dk5ee/LiRX/extra/Versandkosten.png

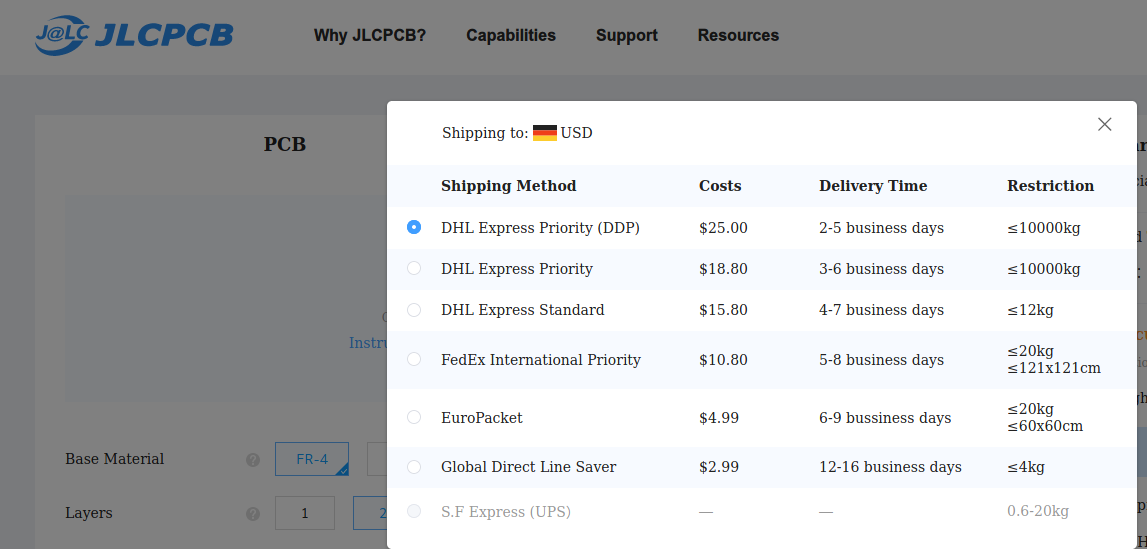
extra/Versandkosten.png
