dk5ee/LiRX/LiRX_3d.png

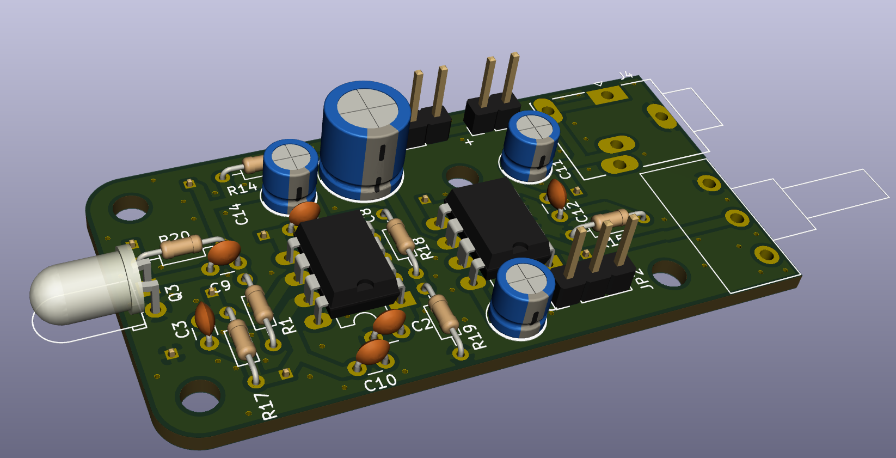
LiRX_3d.png
