dk5ee/LiRX/LiRX_pcb.png

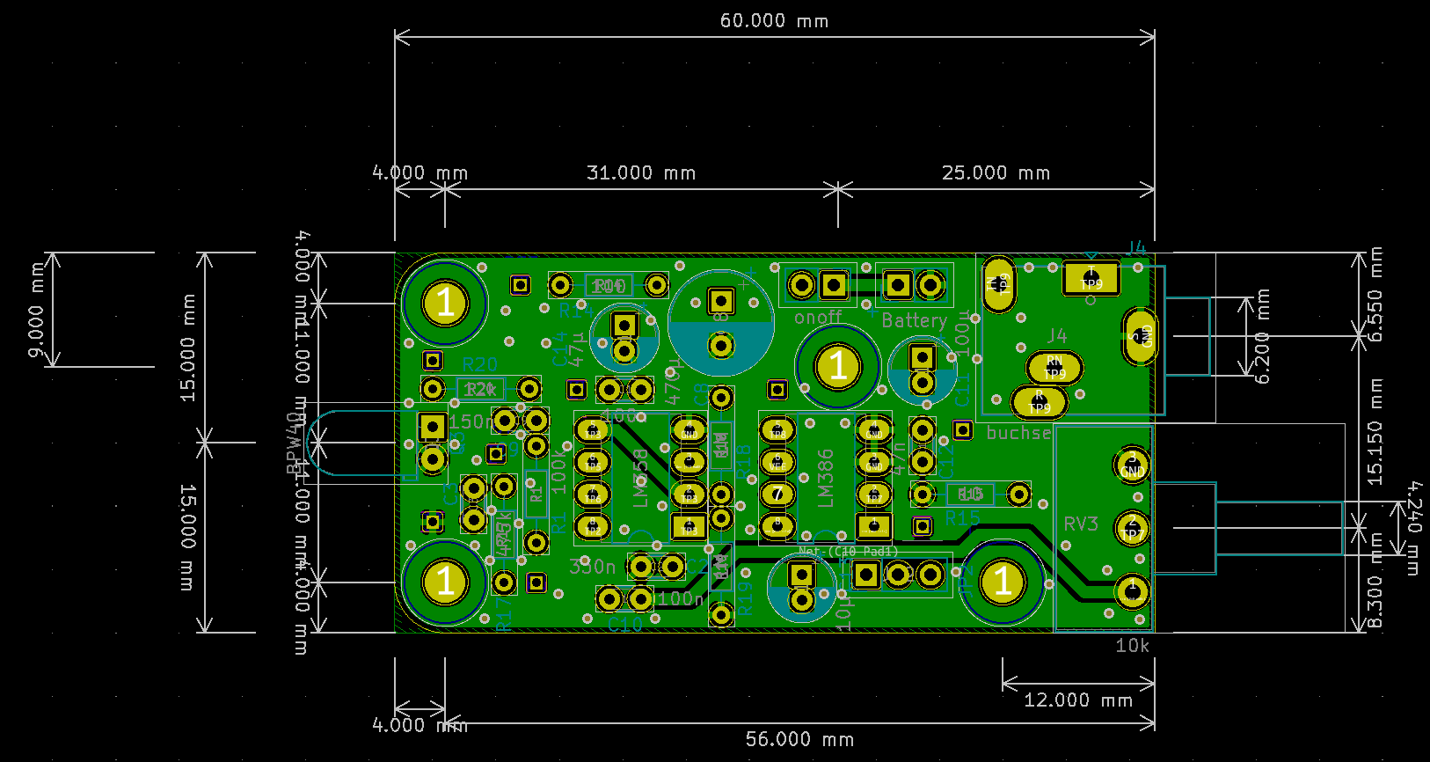
LiRX_pcb.png
