dk5ee/LiRX/LiRX_schematic.png

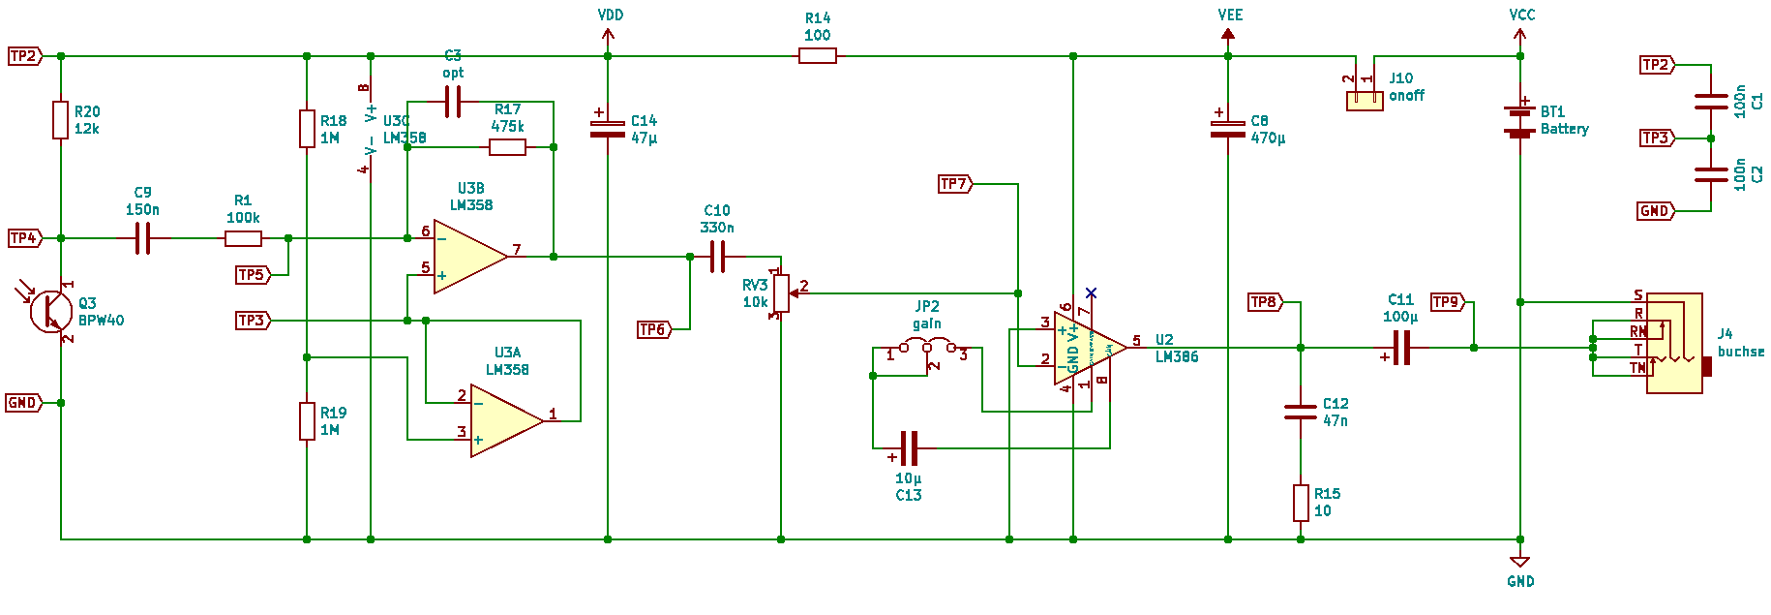
LiRX_schematic.png
