dk5ee/LiRX/LiRXprototype.jpg

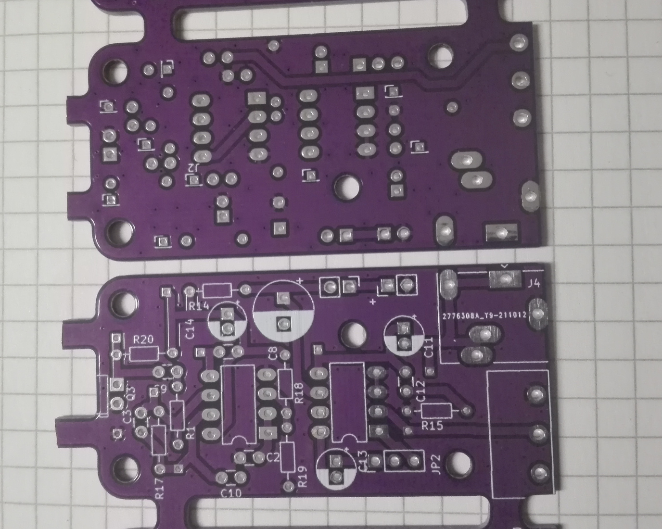
LiRXprototype.jpg
