dk5ee/LiRX/lirx_gehaeuse.stl

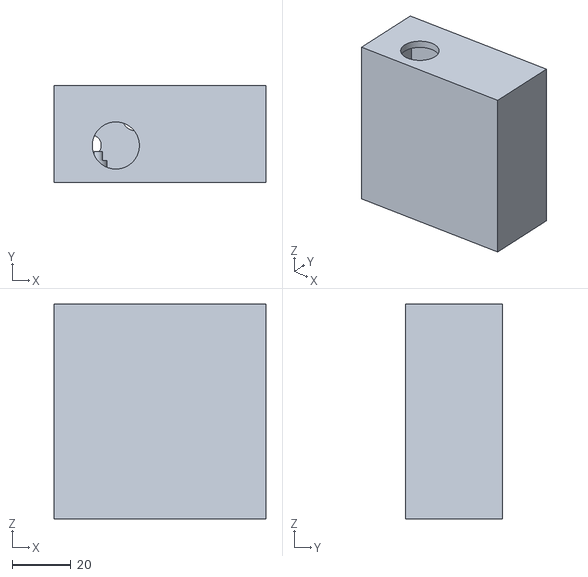
[picture p6: CAD file, 2021-10-19]
lirx_gehaeuse.stl
72.0 x 33.0 x 73.0
