dk5ee/LiRX/LiRX_tht/LiRX_tht.pdf

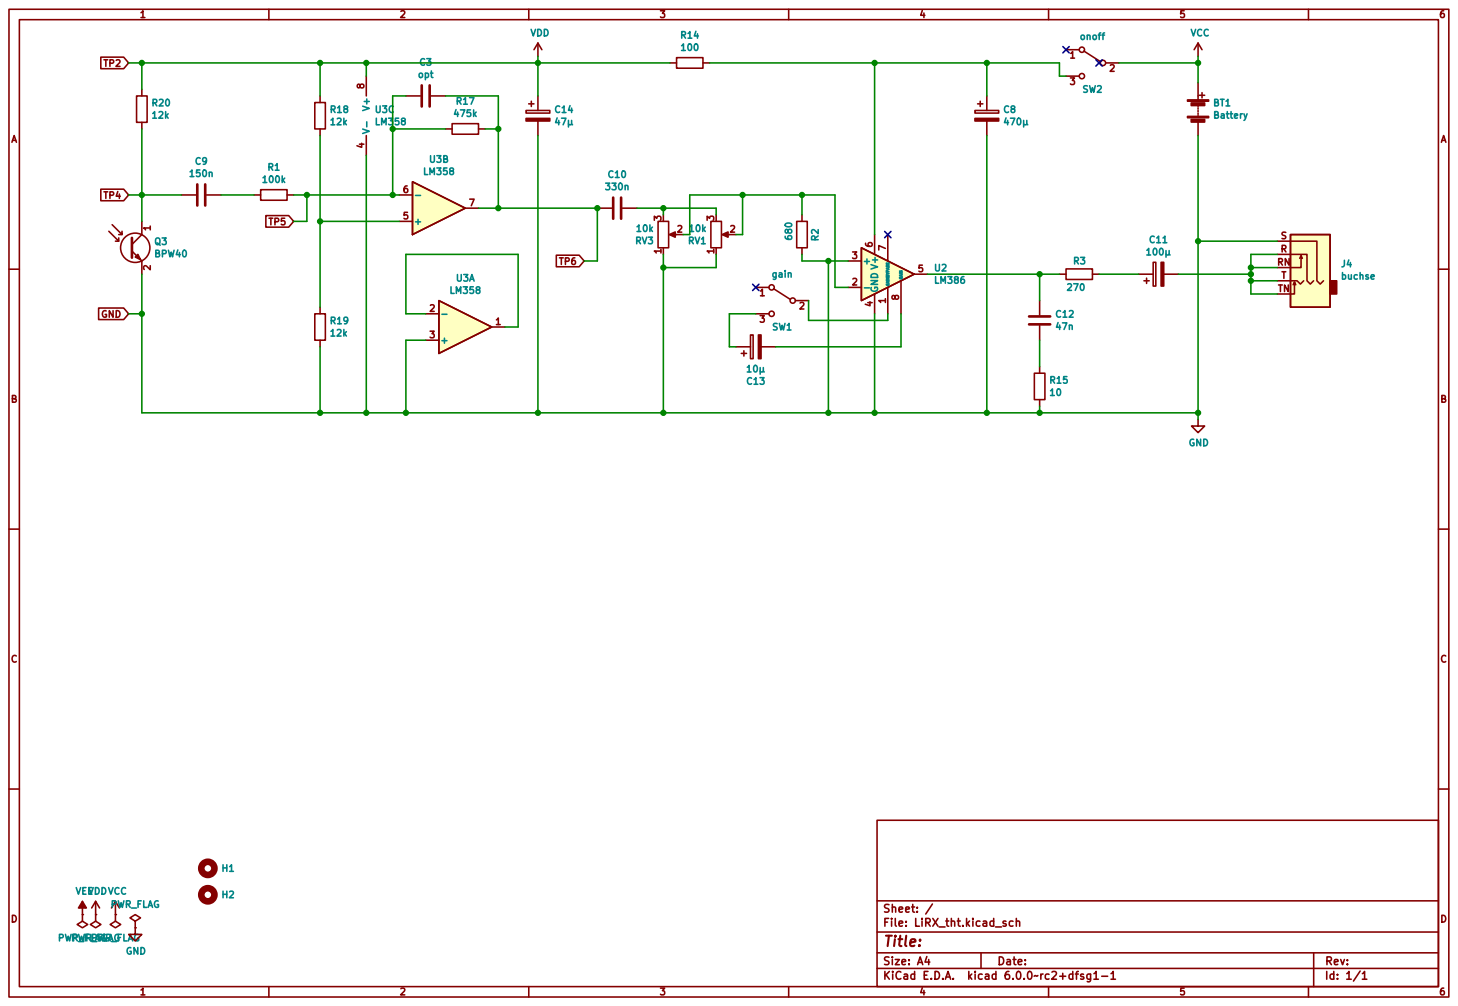
[picture p7: page 1]
