dk5ee/LiRX/LiRX_tht/LiRXgerber/LiRX_tht-B_Cu.pdf

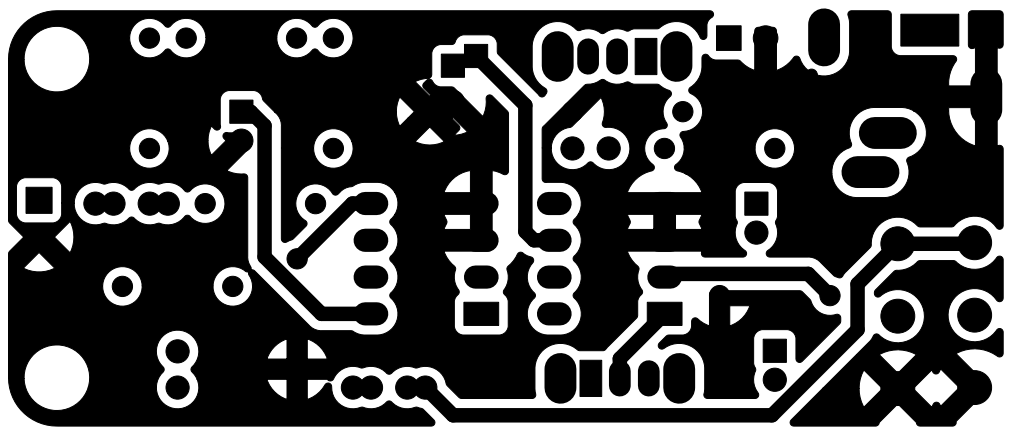
[picture p8: page 1]
