dk5ee/LiRX/LiRX_tht/LiRXgerber/LiRX_tht-B_Mask.pdf

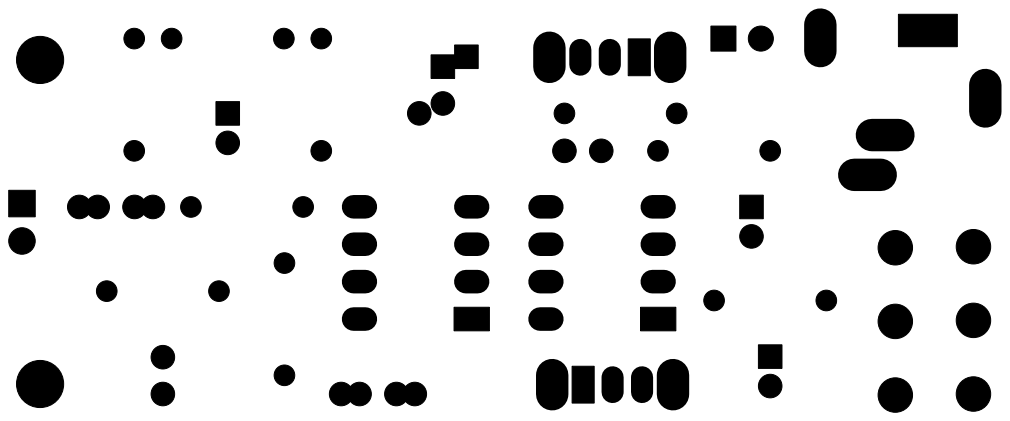
[picture p9: page 1]
