dk5ee/LiRX/LiRX_tht/LiRXgerber/LiRX_tht-Edge_Cuts.pdf

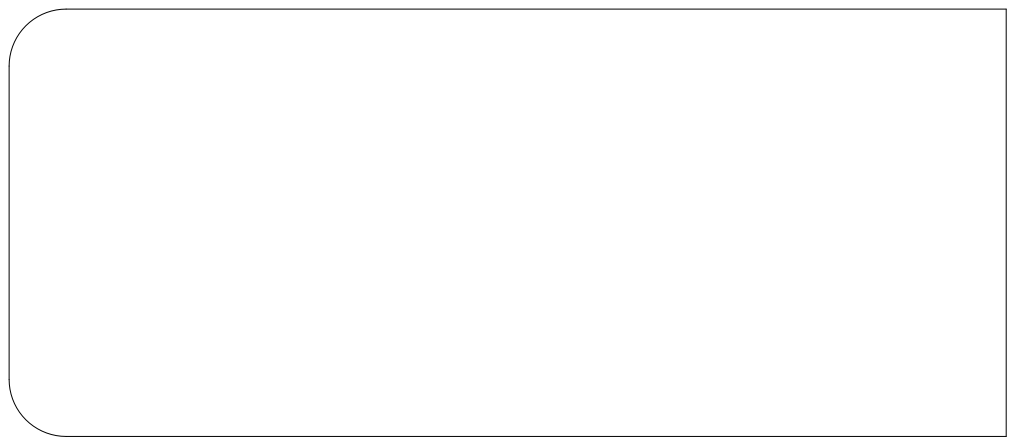
[picture p10: page 1]
