dk5ee/LiRX/LiRX_tht/LiRXgerber/LiRX_tht-F_Cu.pdf

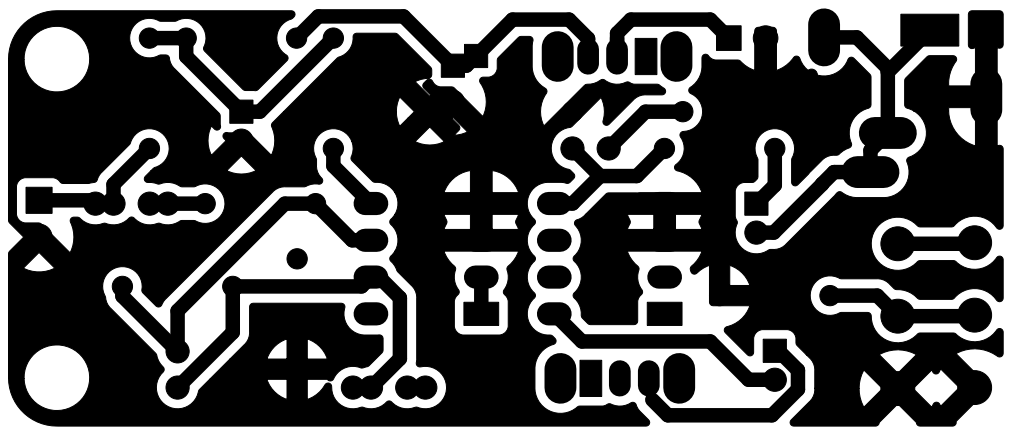
[picture p11: page 1]
