dk5ee/LiRX/LiRX_tht/LiRXgerber/LiRX_tht-F_Silkscreen.pdf

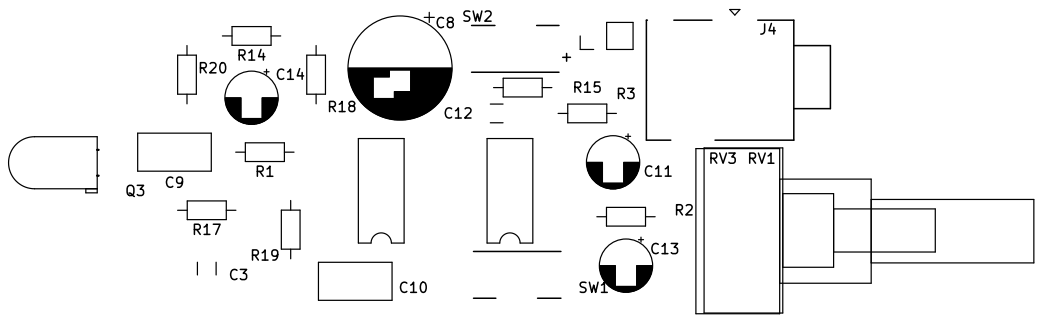
[picture p12: page 1]
