dk5ee/LiRX/LiRX_tht/LiRX_tht.kicad_pcb

## KiCad design LiRX_tht/LiRX_tht.kicad_pcb (2022-01-14)

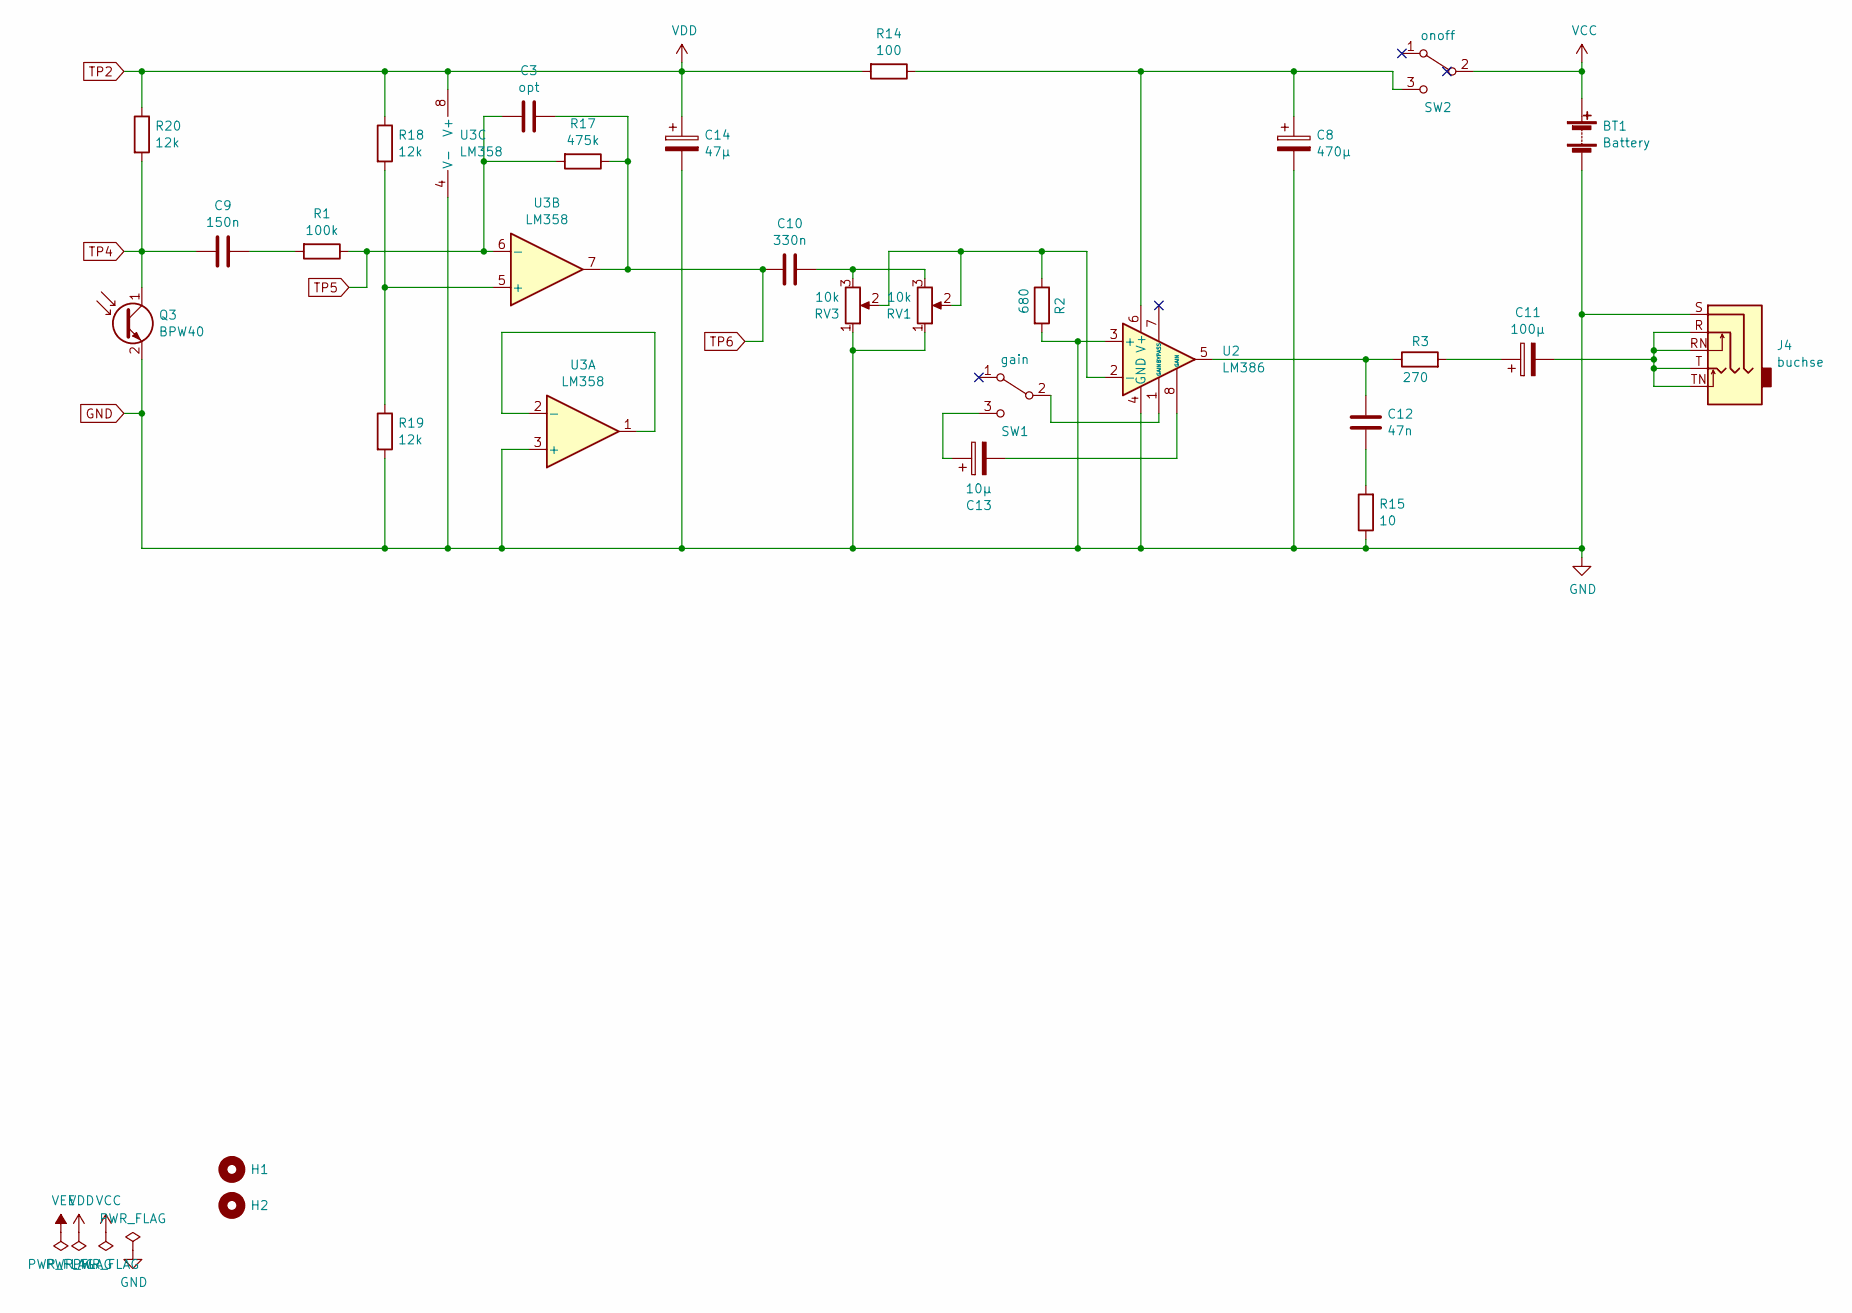
[picture p13: schematic LiRX_tht.kicad_sch]

Parts:
BT1: Battery; PinHeader_1x02_P2.54mm_Vertical
C3: opt; C_Disc_D3.0mm_W1.6mm_P2.50mm
C8: 470µ; CP_Radial_D10.0mm_P2.50mm_P5.00mm
C9: 150n; C_Rect_L7.0mm_W3.5mm_P2.50mm_P5.00mm
C10: 330n; C_Rect_L7.0mm_W3.5mm_P2.50mm_P5.00mm
C11: 100µ; CP_Radial_D5.0mm_P2.00mm
C12: 47n; C_Disc_D3.0mm_W1.6mm_P2.50mm
C13: 10µ; CP_Radial_D5.0mm_P2.00mm
C14: 47µ; CP_Radial_D5.0mm_P2.00mm
H1, H2: MountingHole; MountingHole_3.2mm_M3
J4: buchse; Jack_3.5mm_Ledino_KB3SPRS_Horizontal
Q3: BPW40; LED_D5.0mm_Horizontal_O1.27mm_Z3.0mm_Clear
R1: 100k; R_Axial_DIN0204_L3.6mm_D1.6mm_P7.62mm_Horizontal
R2: 680; R_Axial_DIN0204_L3.6mm_D1.6mm_P7.62mm_Horizontal
R3: 270; R_Axial_DIN0204_L3.6mm_D1.6mm_P7.62mm_Horizontal
R14: 100; R_Axial_DIN0204_L3.6mm_D1.6mm_P7.62mm_Horizontal
R15: 10; R_Axial_DIN0204_L3.6mm_D1.6mm_P7.62mm_Horizontal
R17: 475k; R_Axial_DIN0204_L3.6mm_D1.6mm_P7.62mm_Horizontal
R18, R19, R20: 12k; R_Axial_DIN0204_L3.6mm_D1.6mm_P7.62mm_Horizontal
RV1: 10k; Potentiometer_Piher_T-16H_Single_Horizontal
RV3: 10k; Potentiometer_Piher_PC-16_Single_Horizontal
SW1: gain; SW_CuK_OS102011MA1QN1_SPDT_Angled
SW2: onoff; SW_CuK_OS102011MA1QN1_SPDT_Angled
U2: LM386; DIP-8_W7.62mm_LongPads
U3: LM358; DIP-8_W7.62mm_LongPads

Connections:
GND: BT1.2 (-), C8.2, C14.2, J4.S, Q3.2 (E), R2.2, R15.1, R19.2, RV1.1, RV3.1, U2.3 (+), U2.4 (GND), U3.3 (+), U3.4 (V-)
unnamed: C8.1, R14.1, SW2.3 (C), U2.6 (V+)
unnamed: C9.1, R1.2
unnamed: C10.1, RV1.3, RV3.3
unnamed: C11.1, R3.2
unnamed: C11.2, J4.R, J4.RN, J4.T, J4.TN
unnamed: C12.1, R3.1, U2.5
unnamed: C12.2, R15.2
unnamed: C13.1, SW1.3 (C)
unnamed: C13.2, U2.8 (GAIN)
unnamed: R2.1, RV1.2, RV3.2, U2.2 (-)
unnamed: R18.2, R19.1, U3.5 (+)
unnamed: SW1.2 (B), U2.1 (GAIN)
unnamed: U3.1, U3.2 (-)
TP2: C14.1, R14.2, R18.1, R20.1, U3.8 (V+)
TP4: C9.2, Q3.1 (C), R20.2
TP5: C3.2, R1.1, R17.2, U3.6 (-)
TP6: C3.1, C10.2, R17.1, U3.7
VCC: BT1.1 (+), SW2.2 (B)

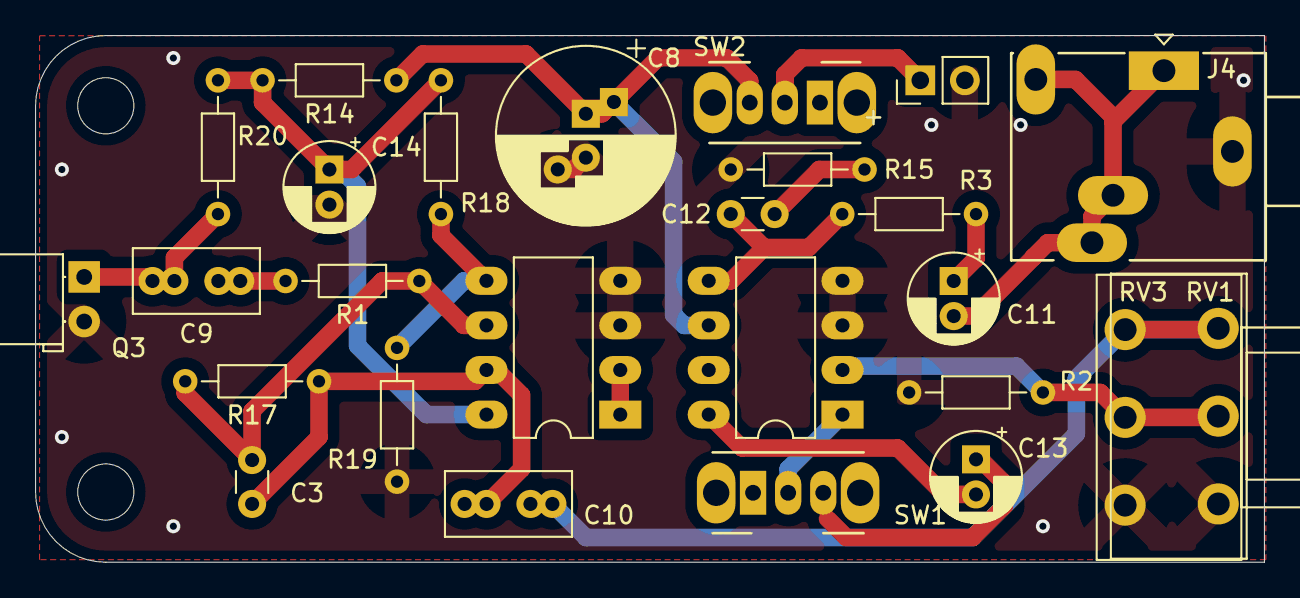
[picture p14: board LiRX_tht.kicad_pcb from above]

Board: 2 copper layers, 70.0 x 30.0 mm, 28 parts (0 on the bottom side), 19 nets.
