dk5ee/LiRX/Anleitung/testpoints.png

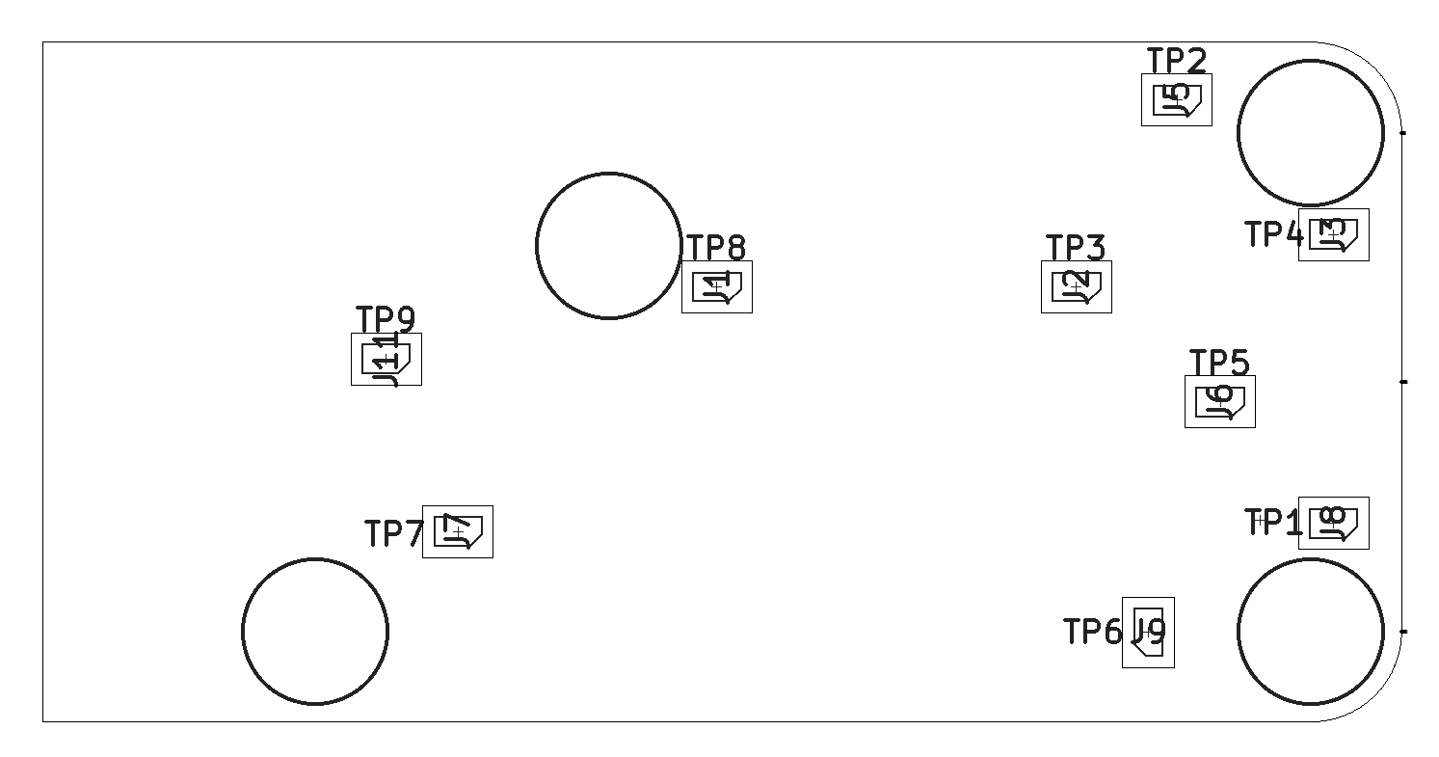
Anleitung/testpoints.png
