dk5ee/LiRX/(commit log)

2021-10-11 import Kicad schematics and PCB
    [LiRX_tht.kicad_pcb, LiRX_tht.sch]
2021-10-11 cleanup and plot
    [LiRX_tht-B_Cu.gbr, LiRX_tht-B_Mask.gbr, LiRX_tht-B_Paste.gbr, LiRX_tht-B_SilkS.gbr, LiRX_tht-Edge_Cuts.gbr, LiRX_tht-F_Cu.gbr, LiRX_tht-F_Mask.gbr, LiRX_tht-F_Paste.gbr]
2021-10-14 correct gitignore to include BOM
    [LiRX_tht.csv]
2021-10-14 Added DXF files
    [LiRX_tht-B_Cu.dxf, LiRX_tht-B_Mask.dxf, LiRX_tht-B_Paste.dxf, LiRX_tht-B_SilkS.dxf, LiRX_tht-Edge_Cuts.dxf, LiRX_tht-F_Cu.dxf, LiRX_tht-F_Mask.dxf, LiRX_tht-F_Paste.dxf]
2021-10-23 picture of prototype
2021-10-26 Schematic PDF
2022-01-05 Added Suggestions; 1cm longer; kicad 6.0
    [LiRX_tht-B_Cu.dxf, LiRX_tht-B_Mask.dxf, LiRX_tht-B_Paste.dxf, LiRX_tht-B_SilkS.dxf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]
2022-01-14 Anleitung verbessert
    [LiRX_tht.kicad_pcb, LiRX_tht_nutzen.kicad_pcb]
2022-03-31 Add files via upload
    Lightburn Projekt für Gehäuse. Fehlt noch Loch für Klammer und Schalter soll versetzt werden.
2022-10-06 neues Gehaeuse auf 3mm
